CoreElectronics/CE-Makerverse-USB-C-LiPo-Charger/README.md

# Makerverse™ USB-C LiPo Charger

This is the repo for the Core Electronics [USB-C LiPo Charger](https://core-electronics.com.au/catalog/product/view/sku/ce08374).

The PCB layout project requires KiCAD 6.0 or newer to view. The schematic is provided in PDF format in the Documents folder.

## License
This project is open source - please review the LICENSE.md file for further licensing information.

If you have any technical questions, or concerns about licensing, please contact technical support on the [Core Electronics forums](https://forum.core-electronics.com.au/).

*\"PiicoDev\" and the PiicoDev logo are trademarks of Core Electronics Pty Ltd.*
