CoreElectronics/CE-Makerverse-USB-C-LiPo-Charger/Documents/schematic.pdf

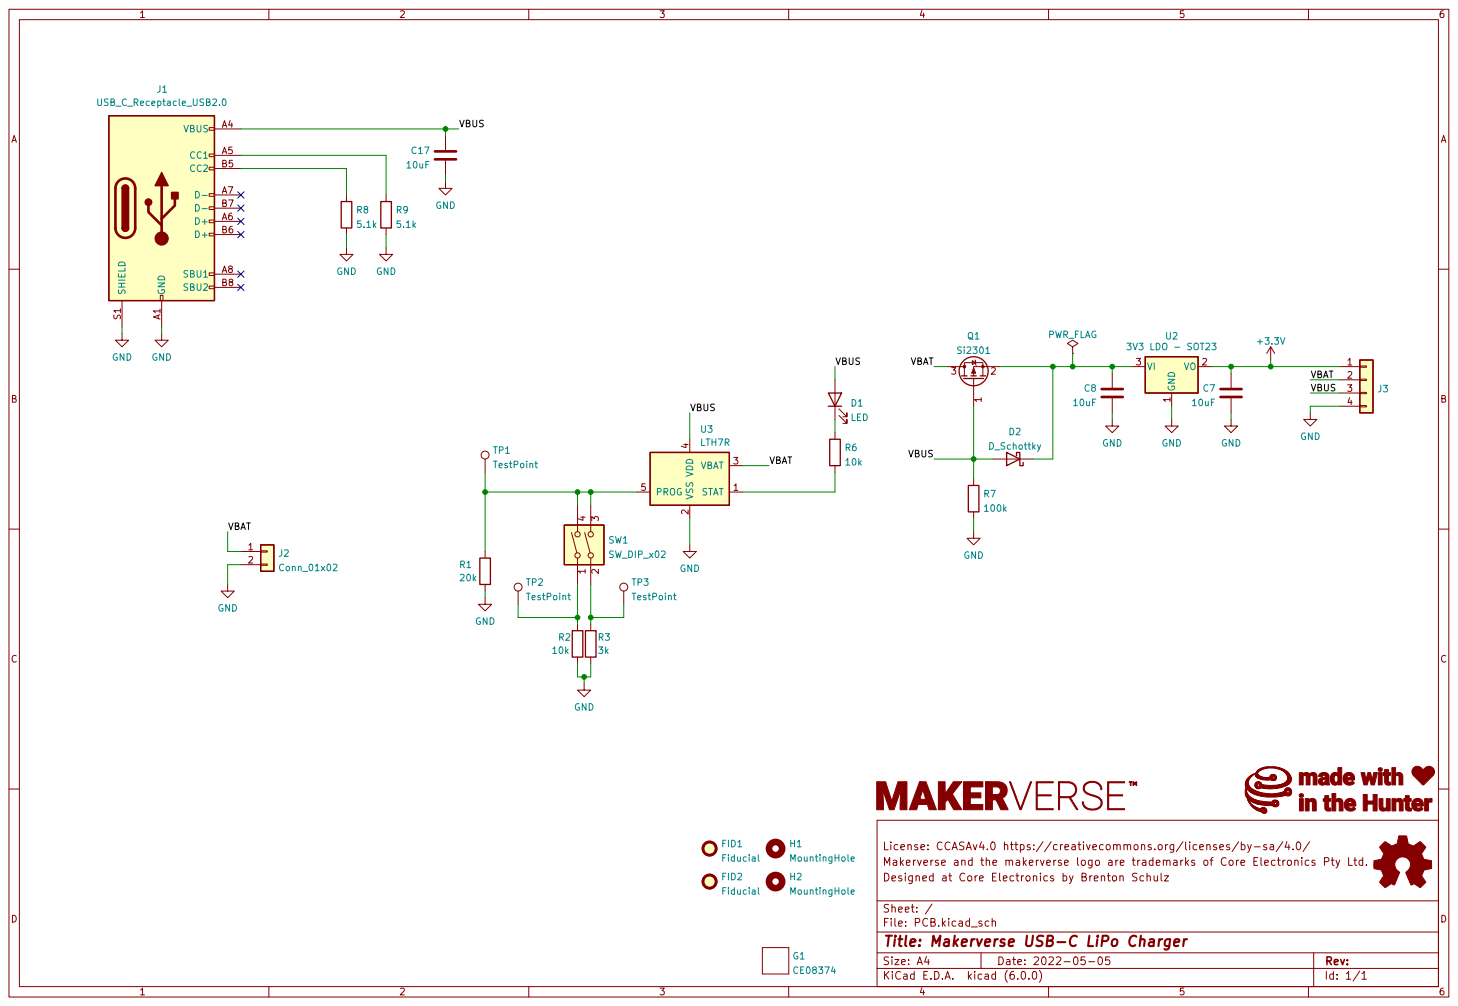
[picture p1: page 1]

License: CCASAv4.0 https://creativecommons.org/licenses/by-sa/4.0/ 1

Makerverse and the makerverse logo are trademarks of Core Electronics Pty Ltd.
File: PCB.kicad_sch Sheet: / Designed at Core Electronics by Brenton Schulz

Id: 1/1 Title: Makerverse USB-C LiPo Charger
