CoreElectronics/CE-Makerverse-USB-C-LiPo-Charger/PCB/PCB.kicad_pcb

## KiCad design PCB/PCB.kicad_pcb (2022-05-05)

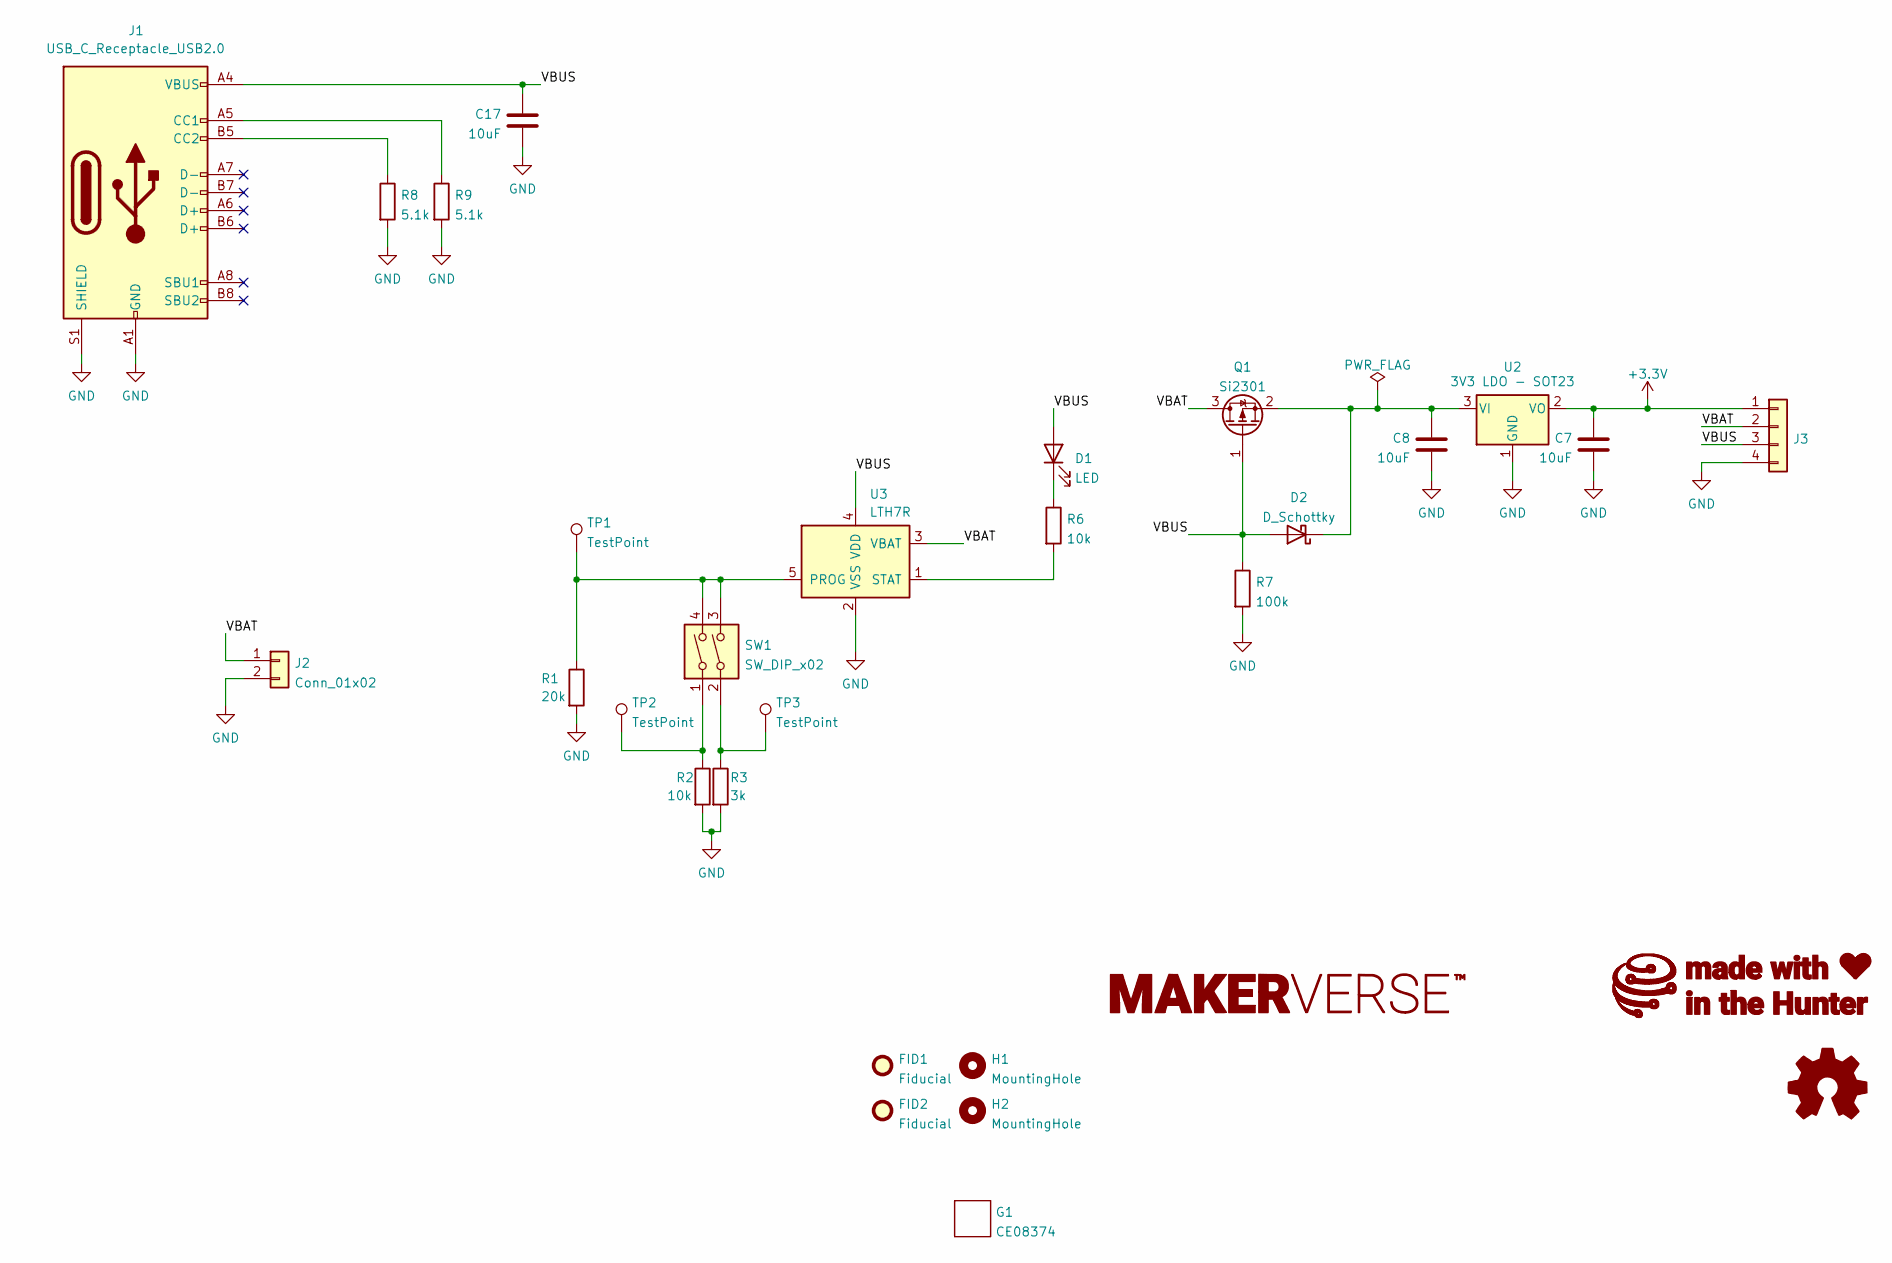
[picture p2: schematic PCB.kicad_sch, Makerverse USB-C LiPo Charger]

Parts:
C7, C8, C17: 10uF; C_0603_1608Metric
D1: LED; LED_0603_1608Metric
D2: D_Schottky; D_SMA
FID1, FID2: Fiducial; Fiducial_1mm_Mask2mm
G1: CE08374
G2: LOGO_Makerverse; makerverse_logo_short_14.0x2.4mm
H1, H2: MountingHole; MountingHole_3.2mm_M3
J1: USB_C_Receptacle_USB2.0; USB_C_Receptacle_HRO_TYPE-C-31-M-12
J2: Conn_01x02; JST_PH_S2B-PH-SM4-TB_1x02-1MP_P2.00mm_Horizontal
J3: Conn_01x04; PinHeader_1x04_P2.54mm_Vertical
LOGO1: Logo_Open_Hardware_Small; oshw_3.9x3.5mm
Q1: Si2301; SOT-23
R1: 20k; R_0402_1005Metric
R2, R6: 10k; R_0402_1005Metric
R3: 3k; R_0402_1005Metric
R7: 100k; R_0402_1005Metric
R8, R9: 5.1k; R_0402_1005Metric
SW1: SW_DIP_x02; SW_DIP_SPSTx02_Slide_Copal_CHS-02A_W5.08mm_P1.27mm_JPin
TP1, TP2, TP3: TestPoint; TestPoint_Pad_D1.5mm
U2: 3V3 LDO - SOT23; SOT-23
U3: LTH7R; SOT-23-5

Connections:
+3V3: C7.1, J3.1, U2.2 (VO)
/VBAT: J2.1, J3.2, Q1.3 (D), U3.3 (VBAT)
/VBUS: C17.1, D1.2 (A), D2.2 (A), J1.A4 (VBUS), J1.A9 (VBUS), J1.B4 (VBUS), J1.B9 (VBUS), J3.3, Q1.1 (G), R7.1, U3.4 (VDD)
GND: C7.2, C8.2, C17.2, J1.A1 (GND), J1.A12 (GND), J1.B1 (GND), J1.B12 (GND), J1.S1 (SHIELD), J2.2, J3.4, R1.2, R2.2, R3.2, R7.2, R8.2, R9.2, U2.1 (GND), U3.2 (VSS)
unnamed: C8.1, D2.1 (K), Q1.2 (S), U2.3 (VI)
unnamed: D1.1 (K), R6.1
unnamed: J1.A5 (CC1), R9.1
unnamed: J1.B5 (CC2), R8.1
unnamed: R1.1, SW1.3, SW1.4, TP1.1, U3.5 (PROG)
unnamed: R2.1, SW1.1, TP2.1
unnamed: R3.1, SW1.2, TP3.1
unnamed: R6.2, U3.1 (STAT)

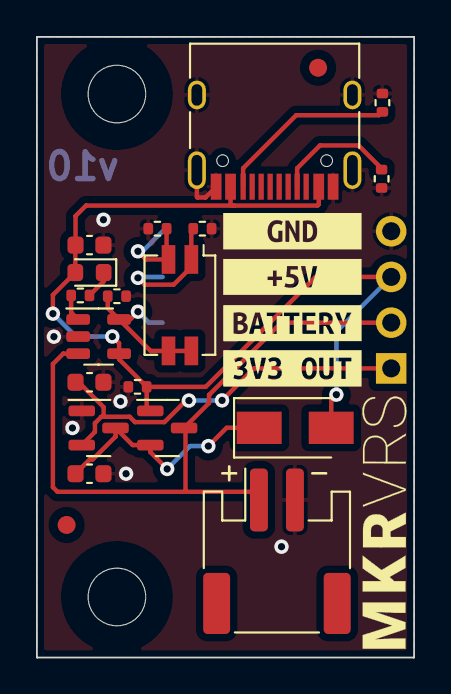
[picture p3: board PCB.kicad_pcb from above]

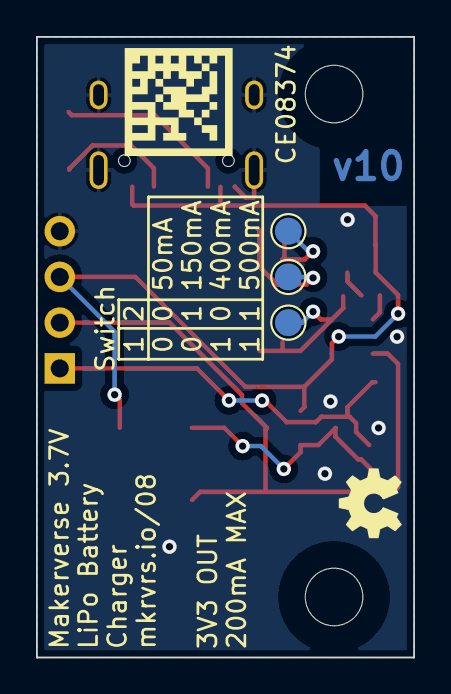
[picture p4: board PCB.kicad_pcb from below]

Board: 2 copper layers, 21.0 x 34.5 mm, 33 parts (5 on the bottom side), 12 nets.

Other parts of the board:
kibuzzard-6216C8F6: G***; kibuzzard-6216C8F6
kibuzzard-6216C913: G***; kibuzzard-6216C913
kibuzzard-6216CAF0: G***; kibuzzard-6216CAF0
kibuzzard-6216CB03: G***; kibuzzard-6216CB03
