CoreElectronics/CE-Makerverse-USB-C-LiPo-Charger/(threads)

Thread 1 (2023-02-08):

USB-C Source - Charging Issue

graham-mitchell-vcs, 2023-02-08:
As reported [here](https://forum.core-electronics.com.au/t/makerverse-usb-c-lipo-charger-ce08374/14307/9):

> Hi, these don’t appear to be standards compliant - they work fine on a type A to type C cable but attempting to run them off of a type C port directly just fails. As far as I can tell this would be caused by failure to include the appropriate resistors on the board to trigger type C chargers.

Community feedback/suggestions are welcomed.

graham-mitchell-vcs, 2023-02-08:
Open source bounty eligible - if someone can replicate the issue and would like to suggest a tested solution then we will provide a $250 store credit @Core Electronics.

Please reply to this topic if you would like to claim this bounty so that others do not work on this in parallel.

Closed 2023-02-09.
